Armastardo/tiebox/PCB/model/RP2040_QFN_PACKAGE.STEP

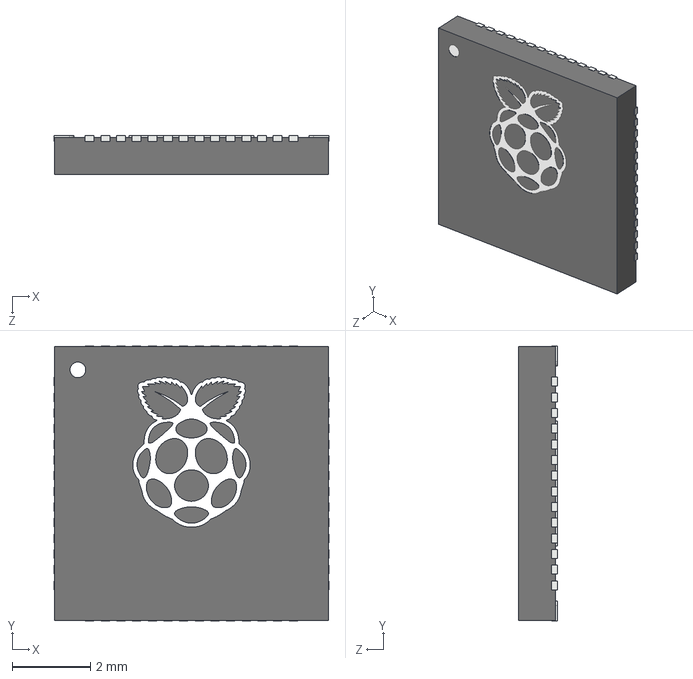
[picture p1: CAD file, 2024-03-06]
PCB/model/RP2040_QFN_PACKAGE.STEP
7.02 x 7.02 x 1.00 mm
