Armastardo/tiebox/PCB/Reference/MX Outline.dxf

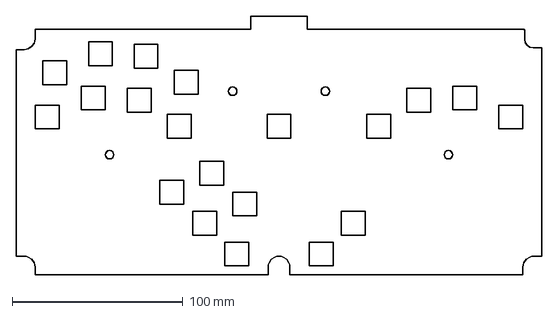
[picture p2: CAD file, 2024-03-06]
PCB/Reference/MX Outline.dxf
308.0 x 151.8 mm
