Armastardo/tiebox/PCB/Reference/LP outline.dxf

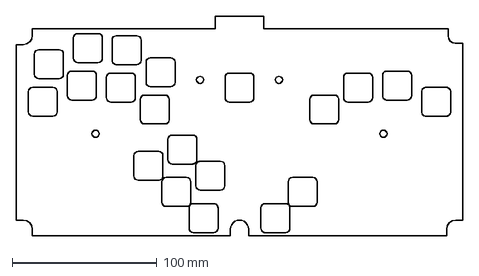
[picture p3: CAD file, 2024-03-06]
PCB/Reference/LP outline.dxf
308.0 x 151.8 mm
