Armastardo/tiebox/PCB/model/2171830001.stp

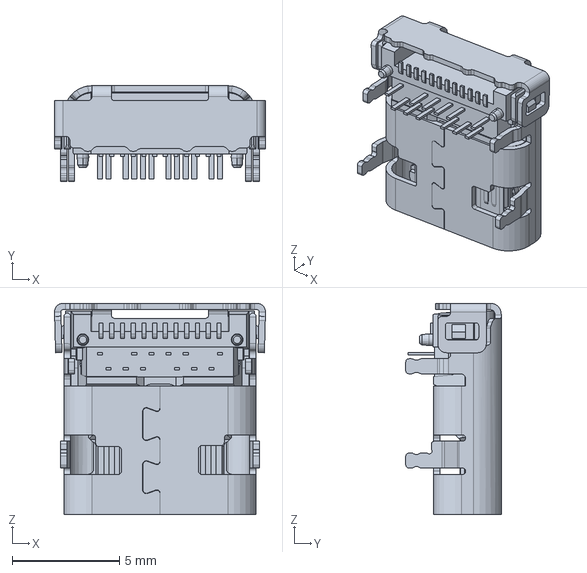
[picture p4: CAD file, 2024-03-06]
PCB/model/2171830001.stp
9.85 x 4.46 x 9.87 mm
