Armastardo/tiebox/PCB/Tiebox.kicad_pcb

## KiCad design PCB/Tiebox.kicad_pcb (2024-03-11)

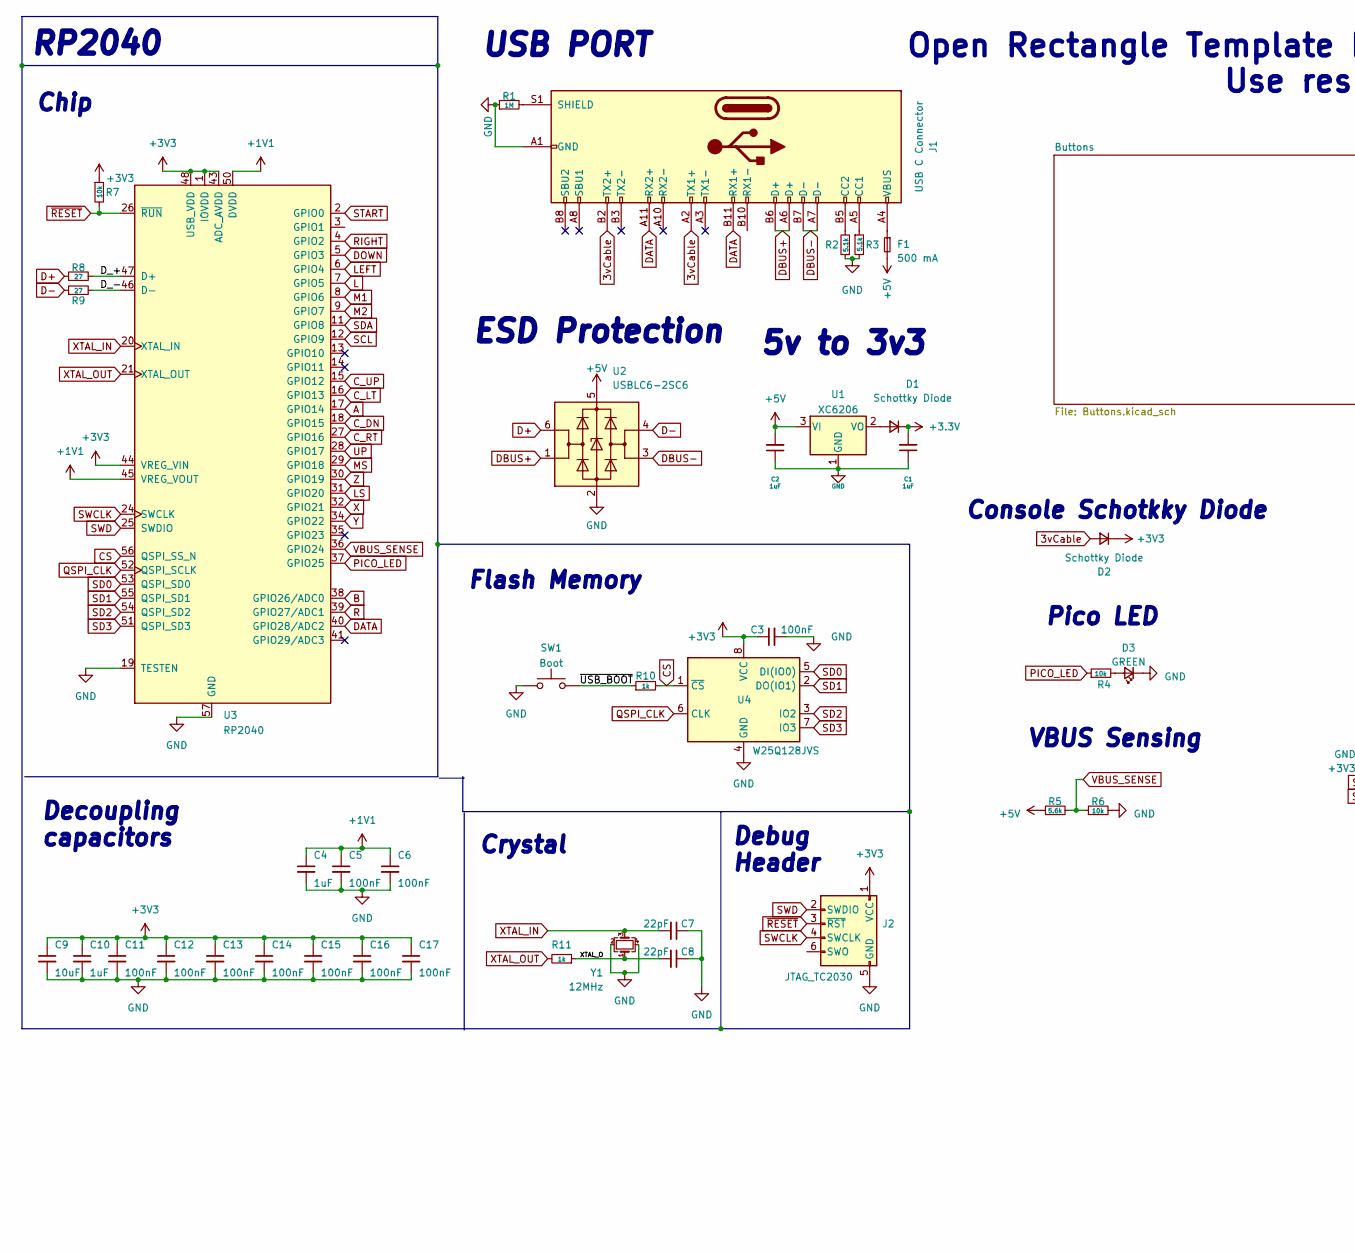
[picture p5: schematic Tiebox.kicad_sch, part in row 1, column 1]

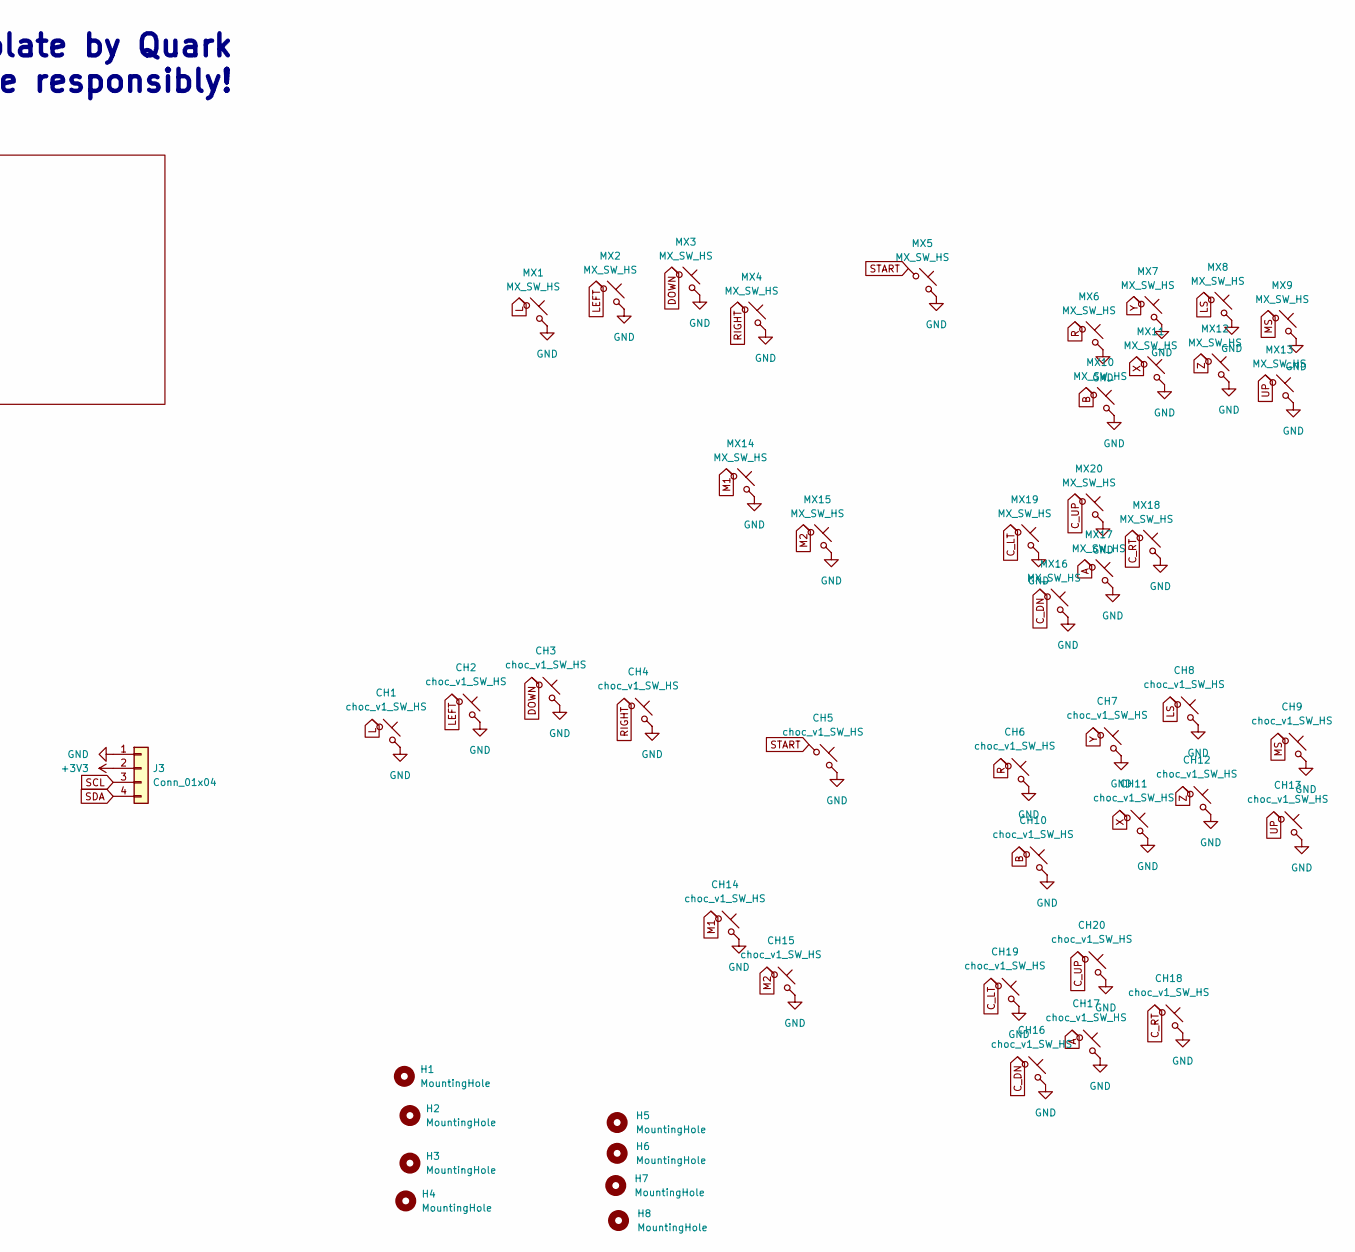
[picture p6: schematic Tiebox.kicad_sch, part in row 1, column 2]

Parts:
C1, C2, C4, C10: 1uF; C_0402_1005Metric; LCSC C52923
C3, C5, C6, C11, C12, C13, C14, C15, C16, C17: 100nF; C_0402_1005Metric; LCSC C1525
C7, C8: 22pF; C_0402_1005Metric; LCSC C1555
C9: 10uF; C_0402_1005Metric; LCSC C15525
CH1, CH2, CH3, CH4, CH5, CH6, CH7, CH8, CH9, CH10, CH11, CH12, CH13, CH14, CH15, CH16, CH17, CH18, CH19, CH20: choc_v1_SW_HS; SW_choc_v1_HS_CPG135001S30_1u
D1, D2: Schottky Diode; D_SOD-123; LCSC C8598
D3: GREEN; LED_0805_2012Metric; LCSC C2297
F1: 500 mA; Fuse_1206_3216Metric; LCSC C70076
H1, H2, H3, H4: MountingHole; MountingHole_3.2mm_M3
H5, H6: MountingHole; qw new logo silk + copper md
H7, H8: MountingHole; 1999 logo md
J1: USB C Connector; TYPE-C_24P_QCHT; LCSC C456013
J2: JTAG_TC2030; CON_TC2030_outlined
J3: Conn_01x04; PinHeader_1x04_P2.54mm_Vertical
MX1, MX2, MX3, MX4, MX5, MX6, MX7, MX8, MX9, MX10, MX11, MX12, MX13, MX14, MX15, MX16, MX17, MX18, MX19, MX20: MX_SW_HS; SW_MX_HS_CPG151101S11_1u
R1: 1M; R_0603_1608Metric; LCSC C22935
R2, R3: 5.1k; R_0402_1005Metric; LCSC C25905
R4, R7: 10k; R_0402_1005Metric; LCSC C25744
R5: 5.6k; R_0603_1608Metric; LCSC C23189
R6: 10k; R_0603_1608Metric; LCSC C25804
R8, R9: 27; R_0603_1608Metric; LCSC C25190
R10, R11: 1k; R_0402_1005Metric; LCSC C11702
SW1: Boot; SW_SPST_SKQG_WithStem; LCSC C318884
U1: XC6206; SOT-23; LCSC C5446
U2: USBLC6-2SC6; SOT-23-6; LCSC C7519
U3: RP2040; RP2040-QFN-56; LCSC C2040
U4: W25Q128JVS; SOIC-8_5.23x5.23mm_P1.27mm; LCSC C97521
Y1: 12MHz; Crystal_SMD_3225-4Pin_3.2x2.5mm; LCSC C9002

Connections:
3vCable: D2.2 (A), J1.A2 (TX1+), J1.B2 (TX2+)
+1V1: C4.1, C5.1, C6.1, U3.23 (DVDD), U3.45 (VREG_VOUT), U3.50 (DVDD)
+5V: C2.2, F1.2, R5.1, U1.3 (VI), U2.5 (VBUS)
/D_+: R8.2, U3.47 (D+)
/D_-: R9.2, U3.46 (D-)
/XTAL_O: C8.2, R11.1, Y1.1
/~USB_BOOT: R10.1, SW1.2
A: CH17.1, MX17.1, U3.17 (GPIO14)
B: CH10.1, MX10.1, U3.38 (GPIO26/ADC0)
CS: R10.2, U3.56 (QSPI_SS_N), U4.1 (~CS)
C_DN: CH16.1, MX16.1, U3.18 (GPIO15)
C_LT: CH19.1, MX19.1, U3.16 (GPIO13)
C_RT: CH18.1, MX18.1, U3.27 (GPIO16)
C_UP: CH20.1, MX20.1, U3.15 (GPIO12)
D+: R8.1, U2.6 (I/O1)
D-: R9.1, U2.4 (I/O2)
DATA: J1.A11 (RX2+), J1.B11 (RX1+), U3.40 (GPIO28/ADC2)
DBUS+: J1.A6 (D+), J1.B6 (D+), U2.1 (I/O1)
DBUS-: J1.A7 (D-), J1.B7 (D-), U2.3 (I/O2)
DOWN: CH3.1, MX3.1, U3.5 (GPIO3)
GND: C1.1, C2.1, C3.2, C4.2, C5.2, C6.2, C7.1, C8.1, C9.2, C10.2, C11.2, C12.2, C13.2, C14.2, C15.2, C16.2, C17.2, CH1.2, CH2.2, CH3.2, CH4.2, CH5.2, CH6.2, CH7.2, CH8.2, CH9.2, CH10.2, CH11.2, CH12.2, CH13.2, CH14.2, CH15.2, CH16.2, CH17.2, CH18.2, CH19.2, CH20.2, D3.1 (K), J1.A1 (GND), J1.A12 (GND), J1.B1 (GND), J1.B12 (GND), J2.5 (GND), J3.1, MX1.2, MX2.2, MX3.2, MX4.2, MX5.2, MX6.2, MX7.2, MX8.2, MX9.2, MX10.2, MX11.2, MX12.2, MX13.2, MX14.2, MX15.2, MX16.2, MX17.2, MX18.2, MX19.2, MX20.2, R1.1, R2.1, R3.2, R6.2, SW1.1, U1.1 (GND), U2.2 (GND), U3.19 (TESTEN), U3.57 (GND), U4.4 (GND), Y1.2, Y1.4
L: CH1.1, MX1.1, U3.7 (GPIO5)
LEFT: CH2.1, MX2.1, U3.6 (GPIO4)
LS: CH8.1, MX8.1, U3.31 (GPIO20)
M1: CH14.1, MX14.1, U3.8 (GPIO6)
M2: CH15.1, MX15.1, U3.9 (GPIO7)
MS: CH9.1, MX9.1, U3.29 (GPIO18)
unnamed: D1.2 (A), U1.2 (VO)
unnamed: D3.2 (A), R4.2
unnamed: F1.1, J1.A4 (VBUS), J1.A9 (VBUS), J1.B4 (VBUS), J1.B9 (VBUS)
unnamed: J1.A5 (CC1), R3.1
unnamed: J1.B5 (CC2), R2.2
unnamed: J1.S1 (SHIELD), R1.2
PICO_LED: R4.1, U3.37 (GPIO25)
QSPI_CLK: U3.52 (QSPI_SCLK), U4.6 (CLK)
R: CH6.1, MX6.1, U3.39 (GPIO27/ADC1)
RIGHT: CH4.1, MX4.1, U3.4 (GPIO2)
SCL: J3.3, U3.12 (GPIO9)
SD0: U3.53 (QSPI_SD0), U4.5 (DI(IO0))
SD1: U3.55 (QSPI_SD1), U4.2 (DO(IO1))
SD2: U3.54 (QSPI_SD2), U4.3 (IO2)
SD3: U3.51 (QSPI_SD3), U4.7 (IO3)
SDA: J3.4, U3.11 (GPIO8)
START: CH5.1, MX5.1, U3.2 (GPIO0)
SWCLK: J2.4 (SWCLK), U3.24 (SWCLK)
SWD: J2.2 (SWDIO), U3.25 (SWDIO)
UP: CH13.1, MX13.1, U3.28 (GPIO17)
VBUS_SENSE: R5.2, R6.1, U3.36 (GPIO24)
X: CH11.1, MX11.1, U3.32 (GPIO21)
XTAL_IN: C7.2, U3.20 (XTAL_IN), Y1.3
XTAL_OUT: R11.2, U3.21 (XTAL_OUT)
Y: CH7.1, MX7.1, U3.34 (GPIO22)
Z: CH12.1, MX12.1, U3.30 (GPIO19)
~RESET: J2.3 (~RST), R7.2, U3.26 (~RUN)

Notes on the sheet:
Console Schotkky Diode
Crystal
USB PORT
Flash Memory
Pico LED
Open Rectangle Template by Quark Use responsibly!
RP2040
Debug Header
VBUS Sensing
Chip
5v to 3v3
ESD Protection
Decoupling capacitors

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
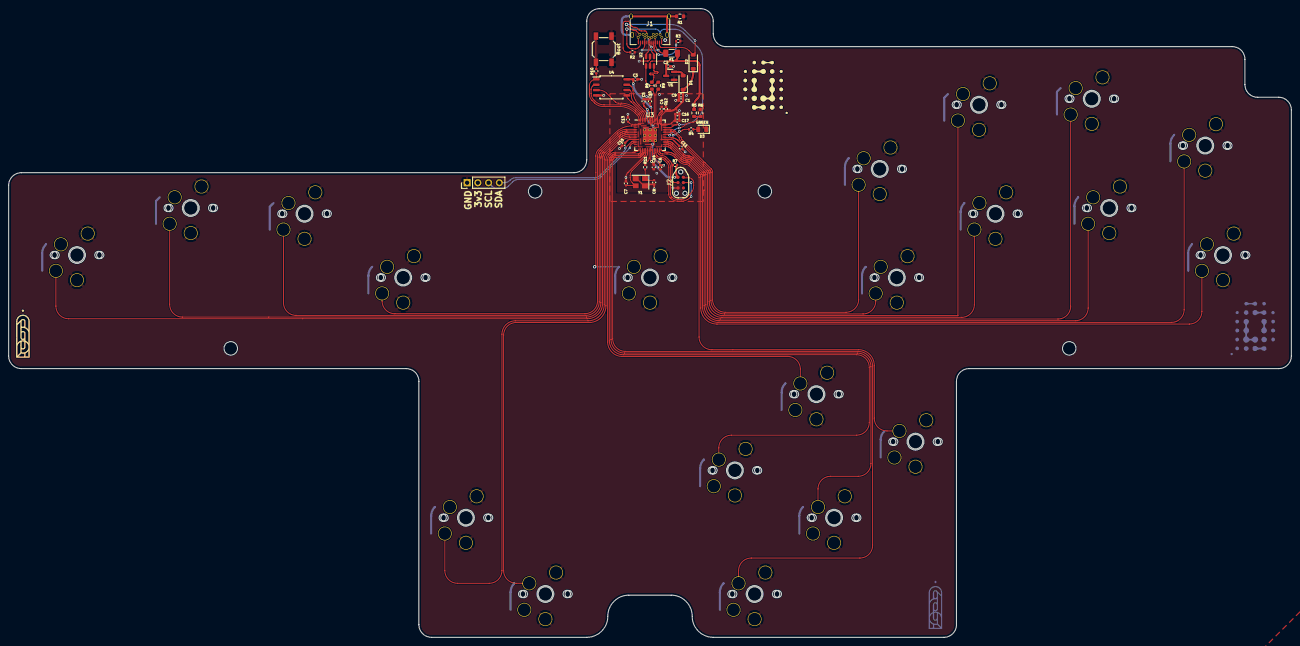
[picture p7: board Tiebox.kicad_pcb from above]

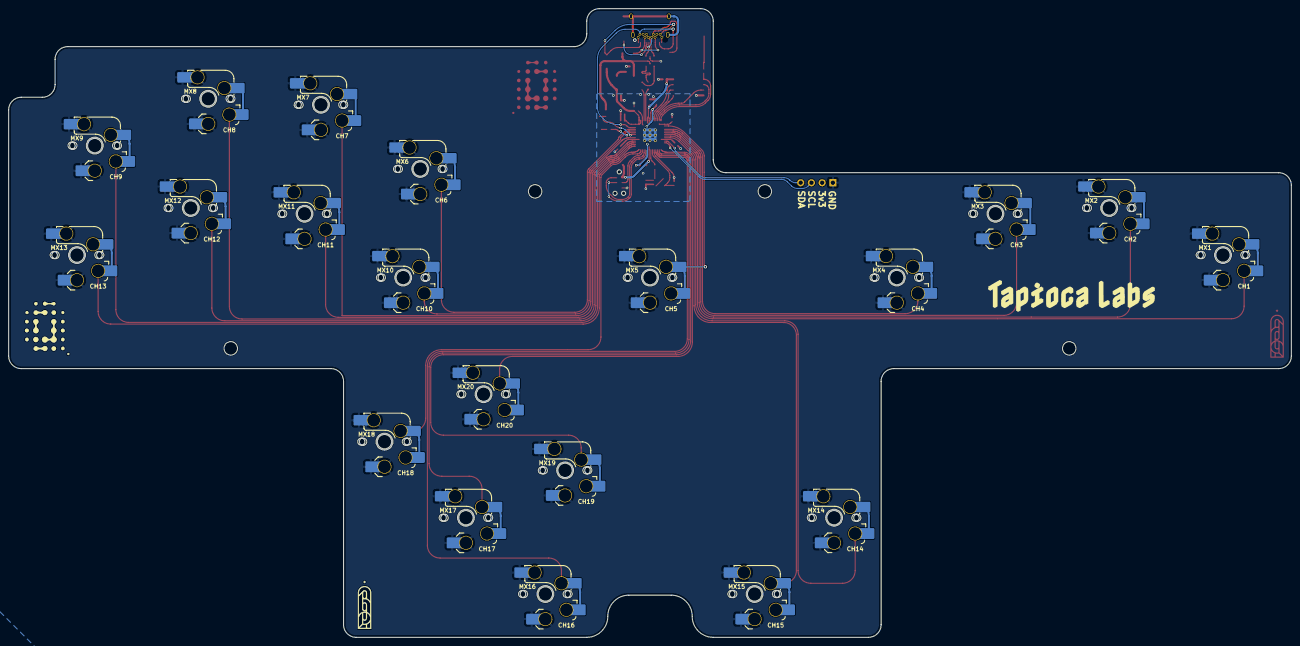
[picture p8: board Tiebox.kicad_pcb from below]

Board: 2 copper layers, 304.0 x 149.0 mm, 89 parts (42 on the bottom side), 55 nets.
